K-Sedgwick/EscapeY2K/ESP GPIO Pin Details.txt

GPIO PINS THAT WORK
   CODE  |  BOARD
    0    ->   D3 -> WORKS AS INPUT
    1    ->   TX -> WORKS AS INPUT
    2    ->   D4
    3    ->   RX
    4    ->   D2 -> WORKS AS INPUT
    5    ->   D1 -> WORKS AS INPUT
    16   ->   D0
    14   ->   D5
    12   ->   D6
    13   ->   D7
    15   ->   D8
