K-Sedgwick/EscapeY2K/Control_Panel_Page/img/reset.png

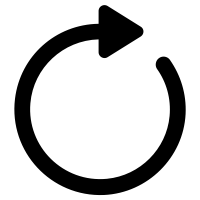
Control_Panel_Page/img/reset.png
