K-Sedgwick/EscapeY2K/Images/EscapeY2K_Wifi_Settings.png

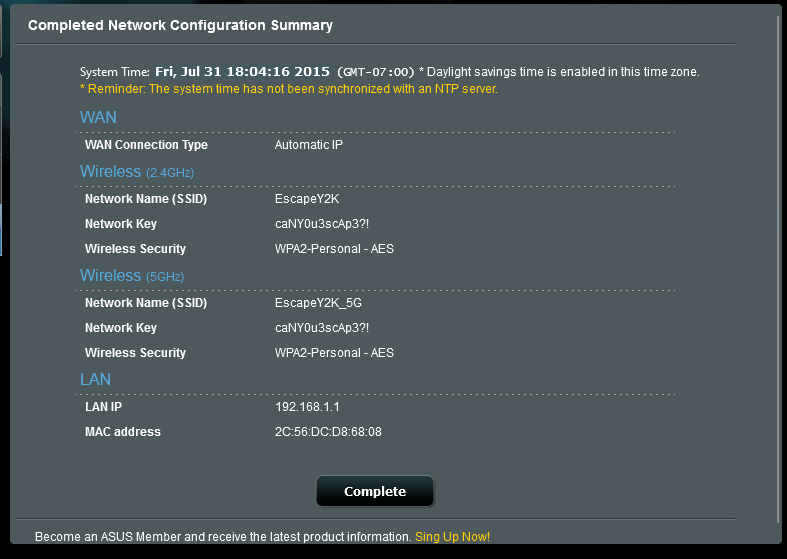
Images/EscapeY2K_Wifi_Settings.png
