K-Sedgwick/EscapeY2K/Project_Document_LaTeX/Images/ClosedLock.png

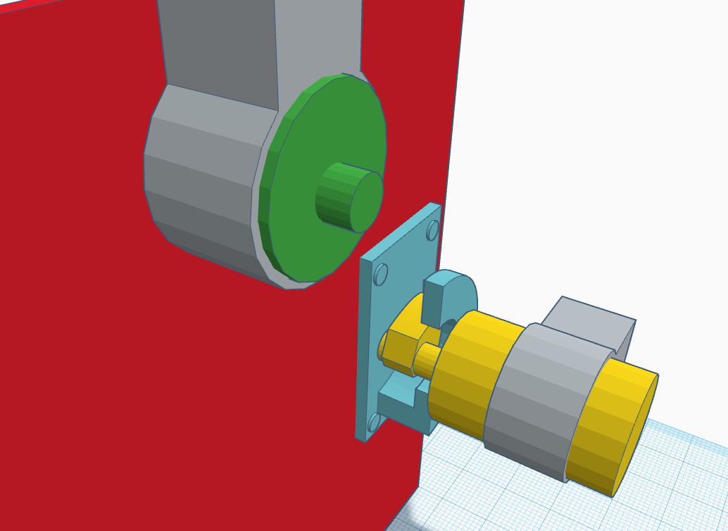
Project_Document_LaTeX/Images/ClosedLock.png
