K-Sedgwick/EscapeY2K/Project_Document_LaTeX/Images/Earfbound3DTrans.png

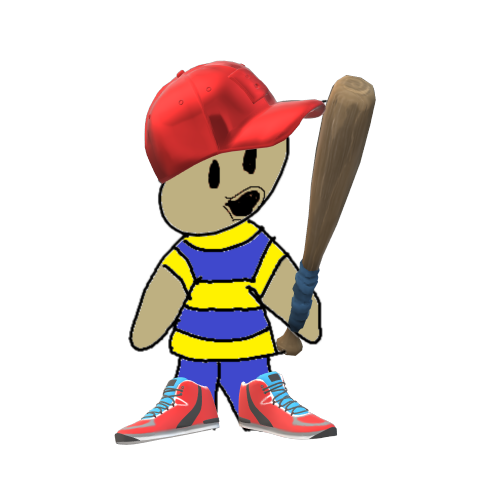
Project_Document_LaTeX/Images/Earfbound3DTrans.png
