K-Sedgwick/EscapeY2K/Project_Document_LaTeX/Images/early_autobox.jpg

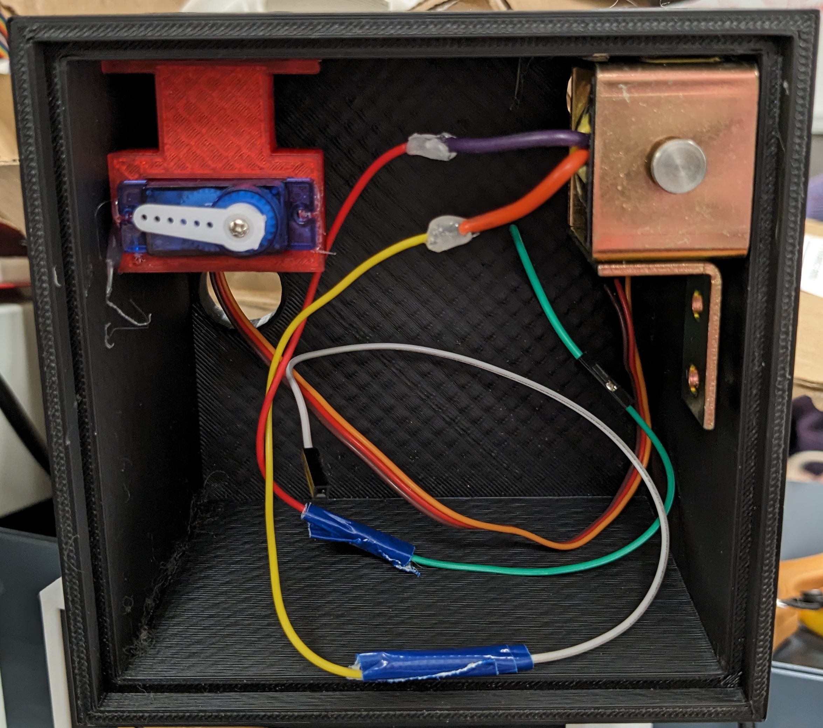
Project_Document_LaTeX/Images/early_autobox.jpg
