K-Sedgwick/EscapeY2K/Project_Document_LaTeX/Images/EscapeRoomIsoFront.jpg

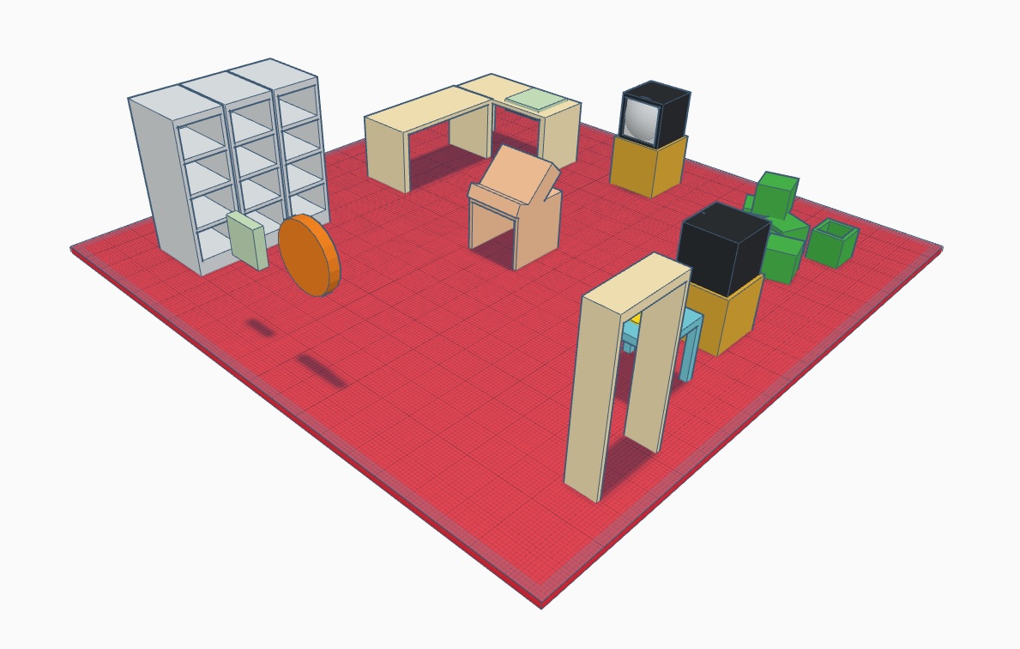
Project_Document_LaTeX/Images/EscapeRoomIsoFront.jpg
