K-Sedgwick/EscapeY2K/Project_Document_LaTeX/Images/EscapeRoomIsoRear.jpg

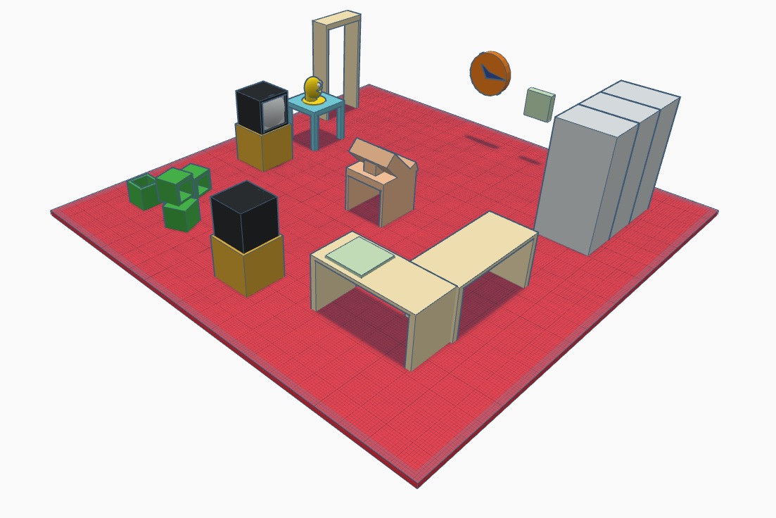
Project_Document_LaTeX/Images/EscapeRoomIsoRear.jpg
