K-Sedgwick/EscapeY2K/Project_Document_LaTeX/Images/OpenLock.png

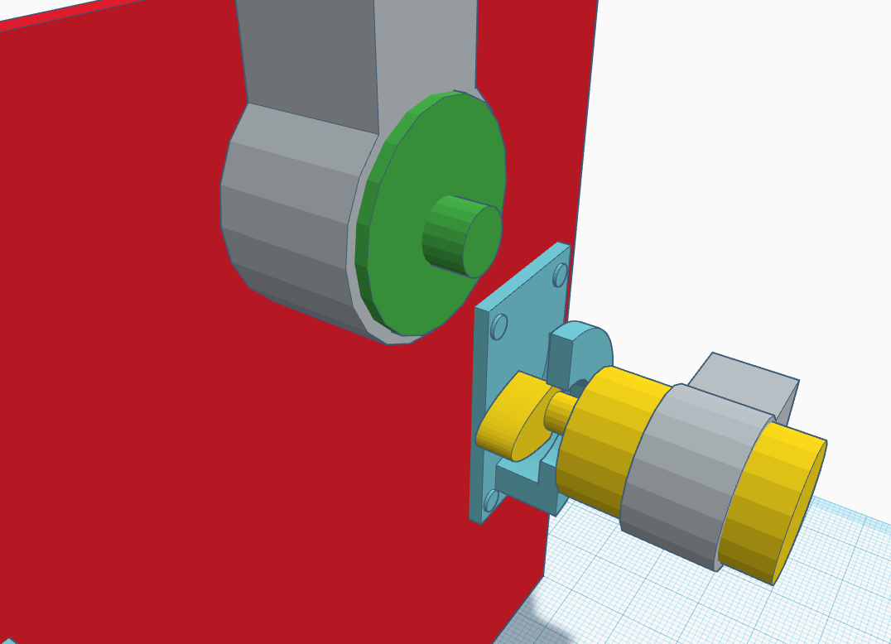
Project_Document_LaTeX/Images/OpenLock.png
