K-Sedgwick/EscapeY2K/Project_Document_LaTeX/Images/pebble charger.jpg

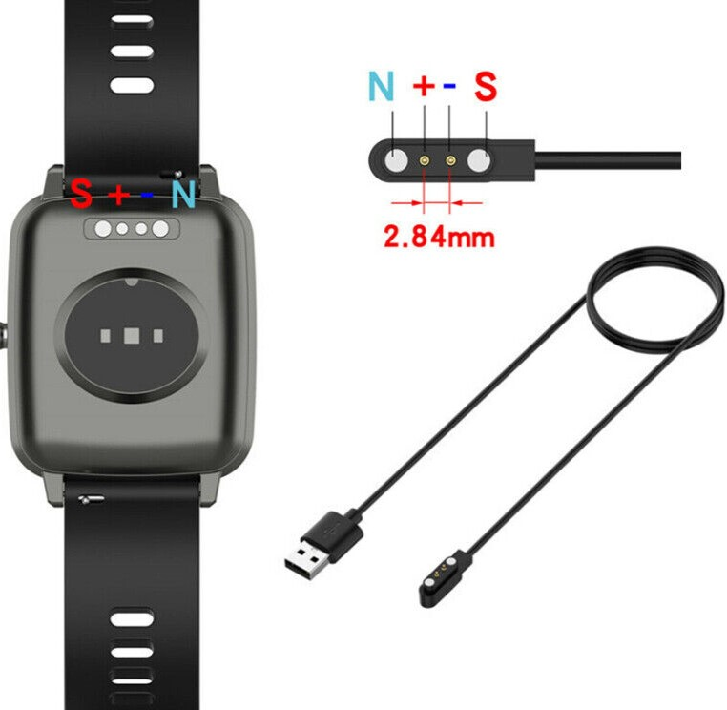
Project_Document_LaTeX/Images/pebble charger.jpg
