K-Sedgwick/EscapeY2K/Project_Document_LaTeX/Images/plugboard.jpg

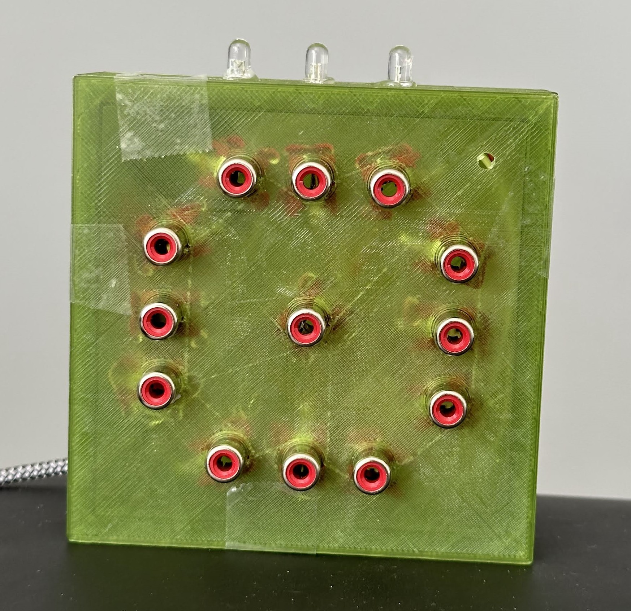
Project_Document_LaTeX/Images/plugboard.jpg
