K-Sedgwick/EscapeY2K/Project_Document_LaTeX/Images/tvcomparison.png

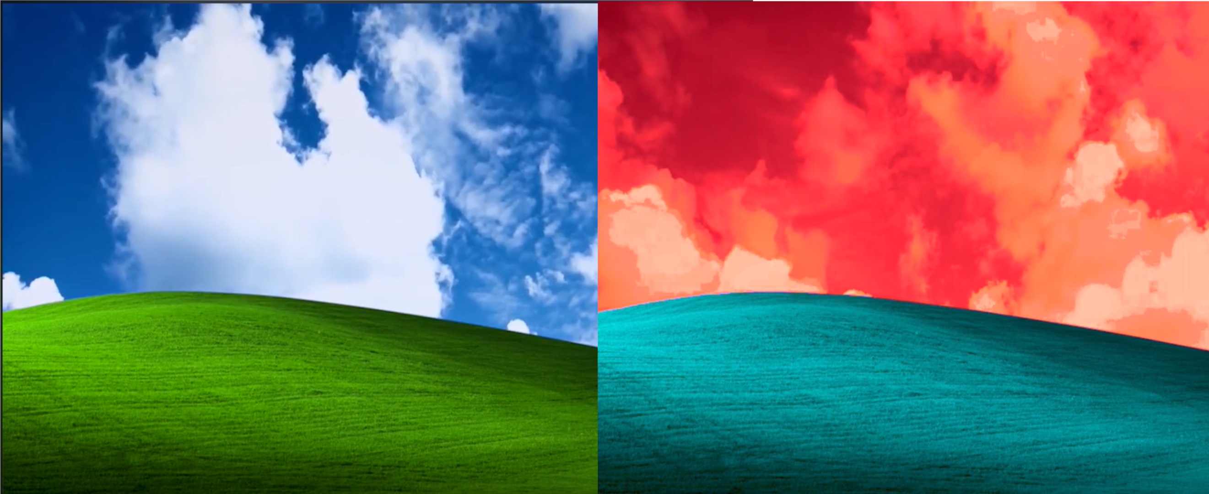
Project_Document_LaTeX/Images/tvcomparison.png
