K-Sedgwick/EscapeY2K/Project_Document_LaTeX/Images/tvsketch.png

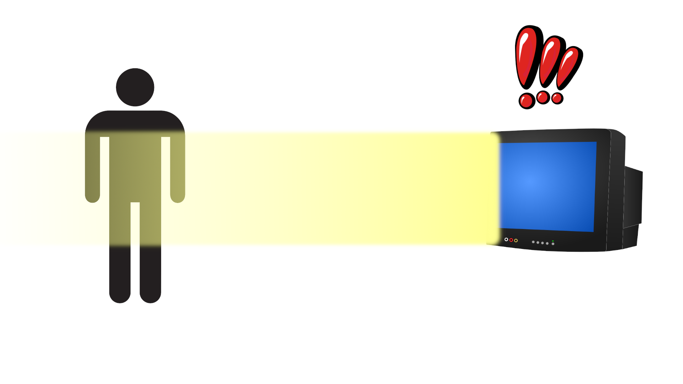
Project_Document_LaTeX/Images/tvsketch.png
