K-Sedgwick/EscapeY2K/Project_Document_LaTeX/newenergytable.png

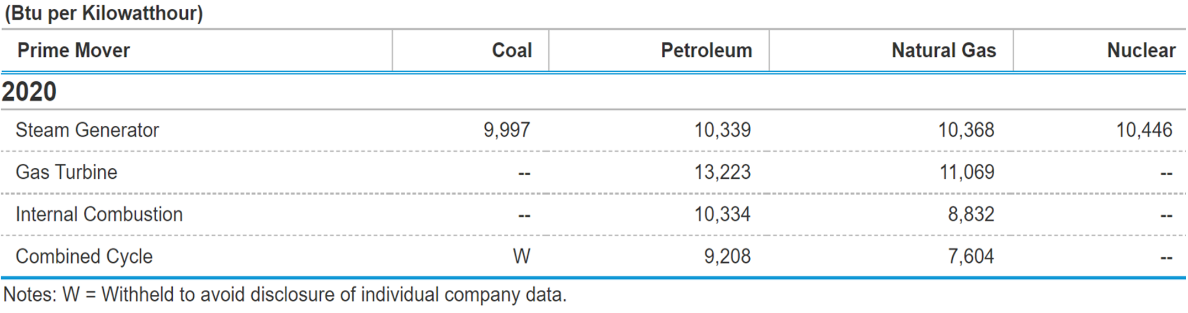
Project_Document_LaTeX/newenergytable.png
