K-Sedgwick/EscapeY2K/Website/img/celery.png

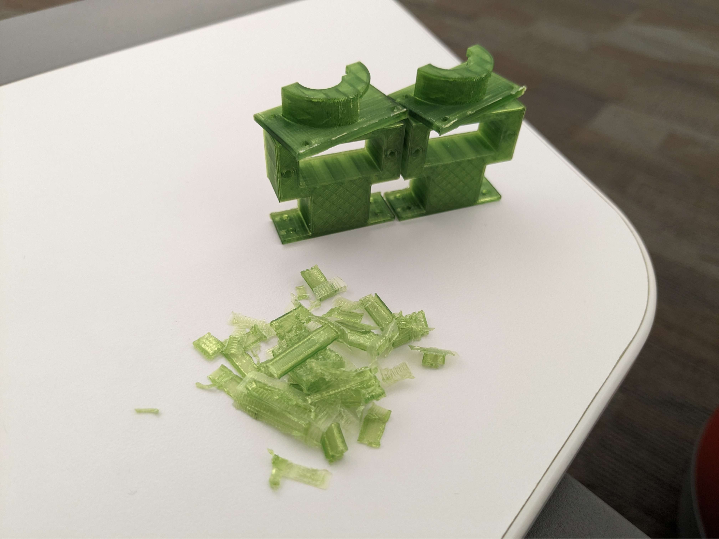
Website/img/celery.png
