K-Sedgwick/EscapeY2K/Website/img/classified-note.png

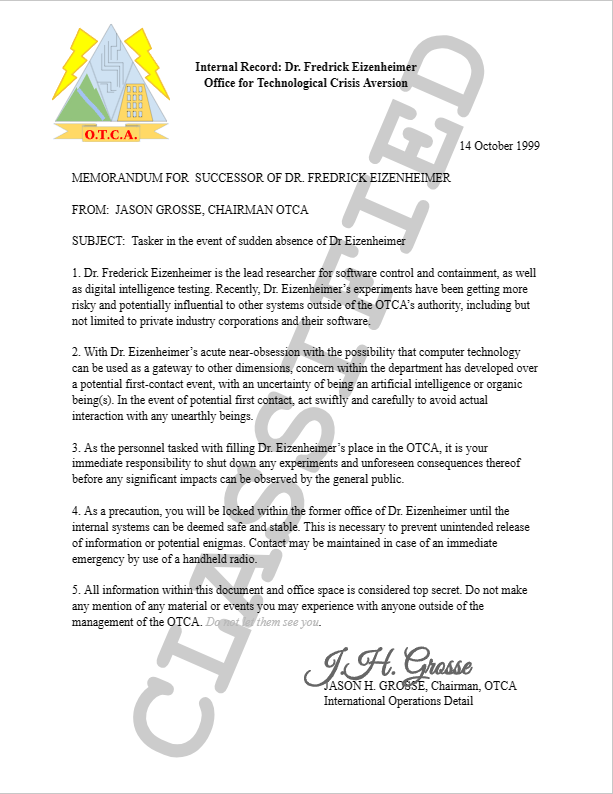
Website/img/classified-note.png
