K-Sedgwick/EscapeY2K/Website/img/clock-rotary-mount.jpg

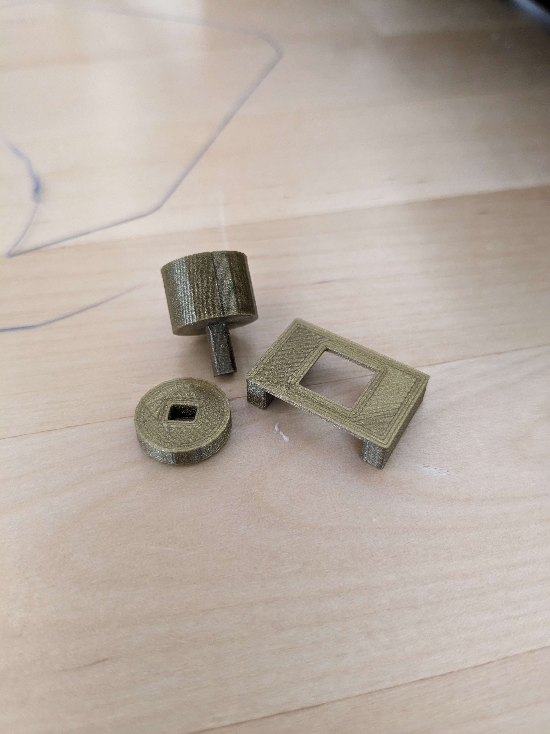
Website/img/clock-rotary-mount.jpg
