K-Sedgwick/EscapeY2K/Website/img/combos.png

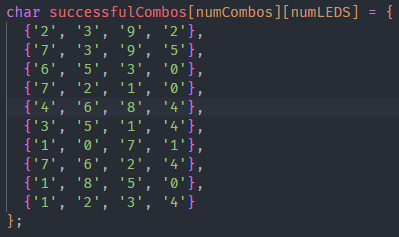
Website/img/combos.png
