K-Sedgwick/EscapeY2K/Website/img/dial-back-in-plate.png

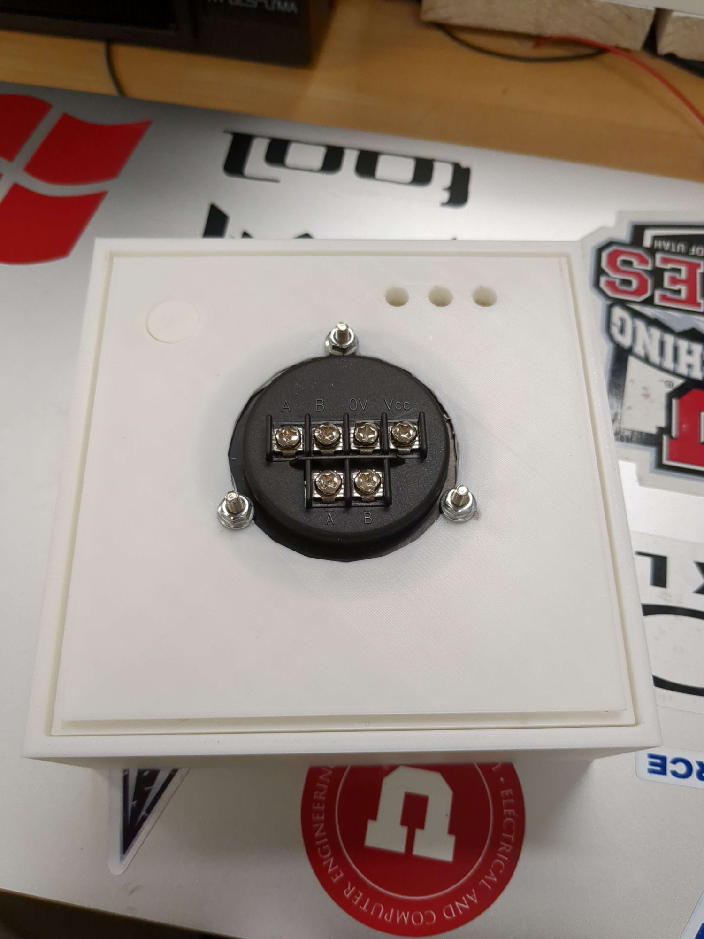
Website/img/dial-back-in-plate.png
