K-Sedgwick/EscapeY2K/Website/img/dial.png

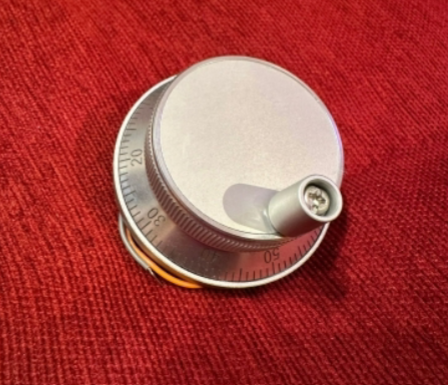
Website/img/dial.png
