K-Sedgwick/EscapeY2K/Website/img/door open.png

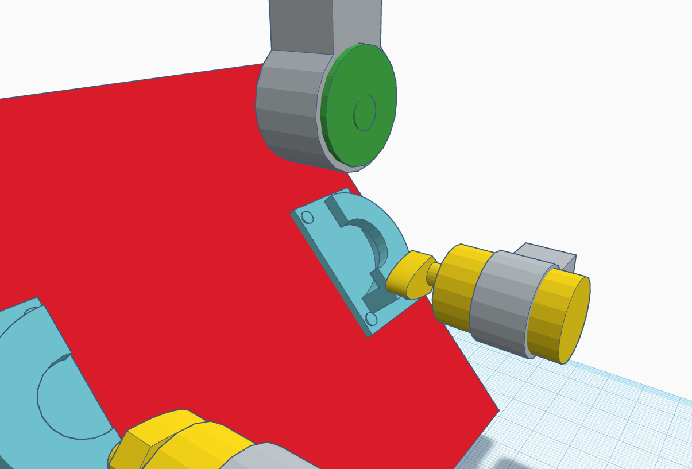
Website/img/door open.png
