K-Sedgwick/EscapeY2K/Website/img/door with locks.png

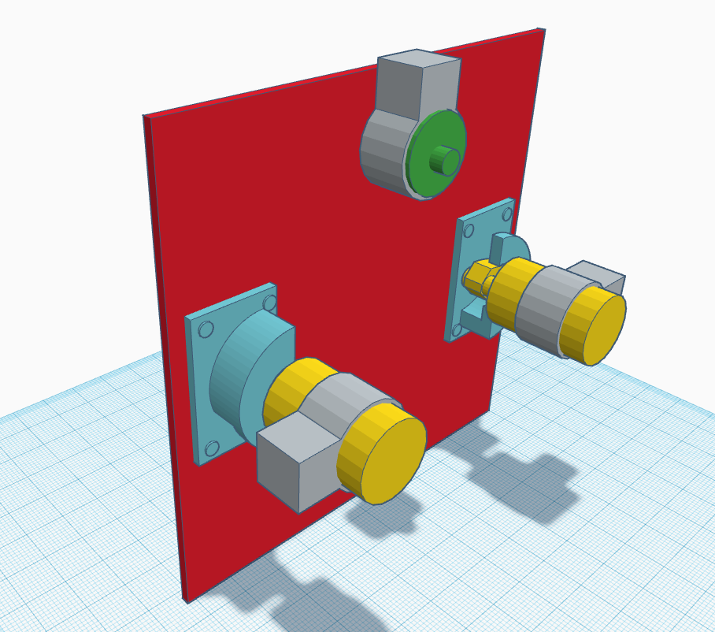
Website/img/door with locks.png
