K-Sedgwick/EscapeY2K/Website/img/Escape Room Y2K.jpg

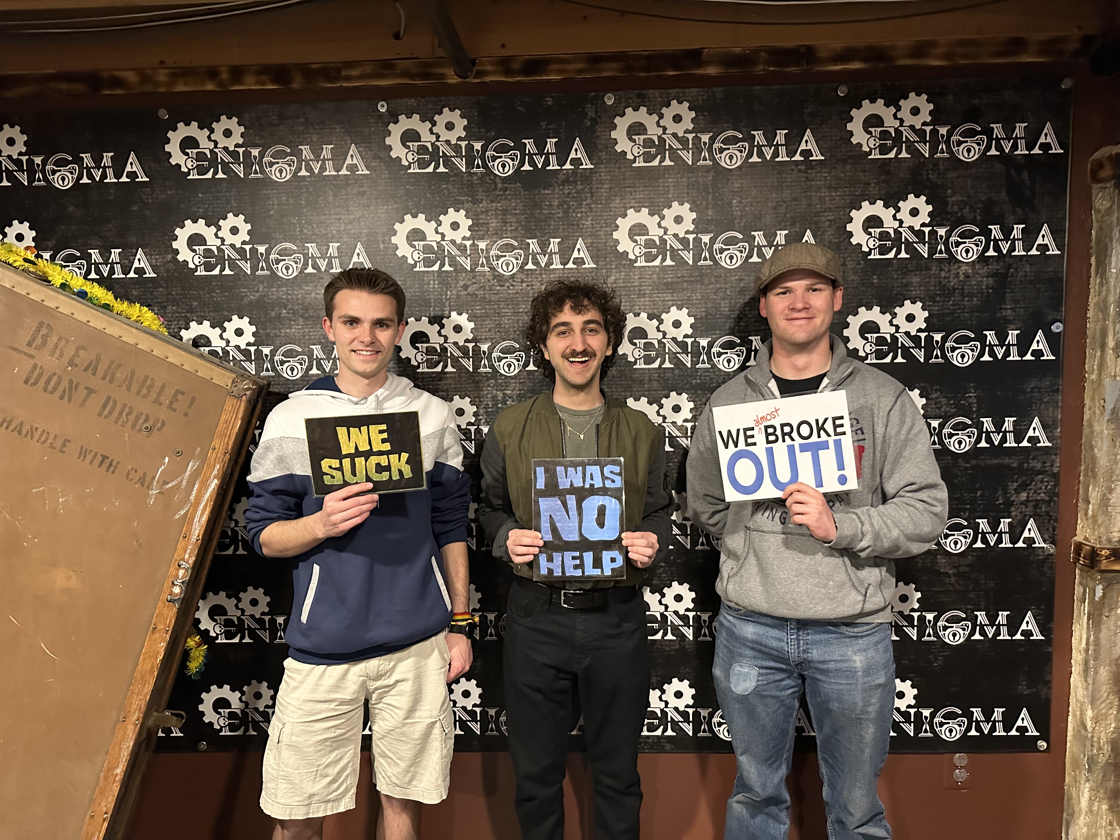
Website/img/Escape Room Y2K.jpg
