K-Sedgwick/EscapeY2K/Website/img/escape-room-2.jpg

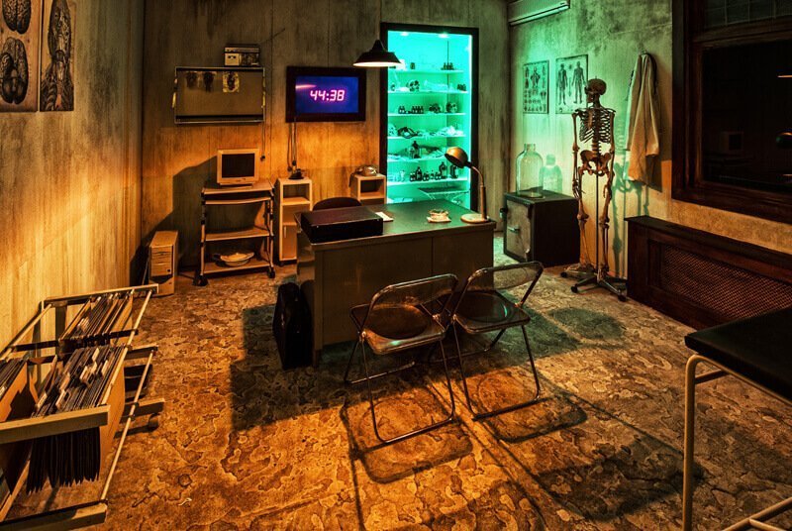
Website/img/escape-room-2.jpg
