K-Sedgwick/EscapeY2K/Website/img/final-box-pcb.png

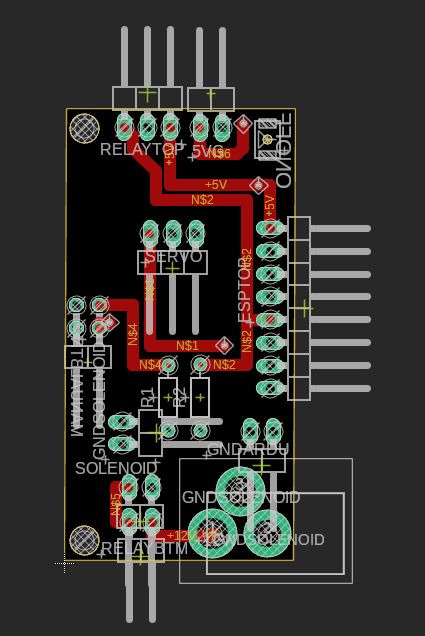
Website/img/final-box-pcb.png
