K-Sedgwick/EscapeY2K/Website/img/hiding-from-monster.jpg

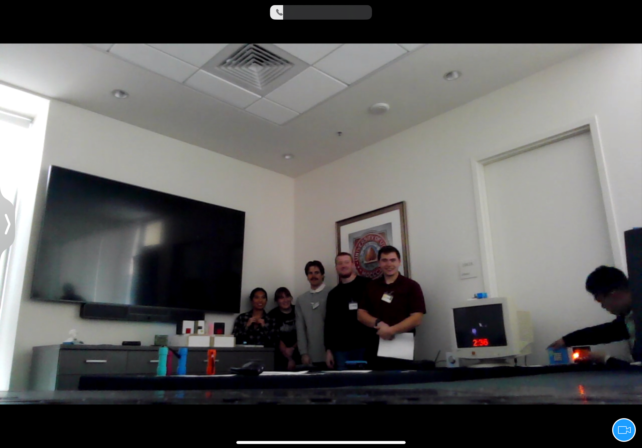
Website/img/hiding-from-monster.jpg
