K-Sedgwick/EscapeY2K/Website/img/jake-pic.JPG

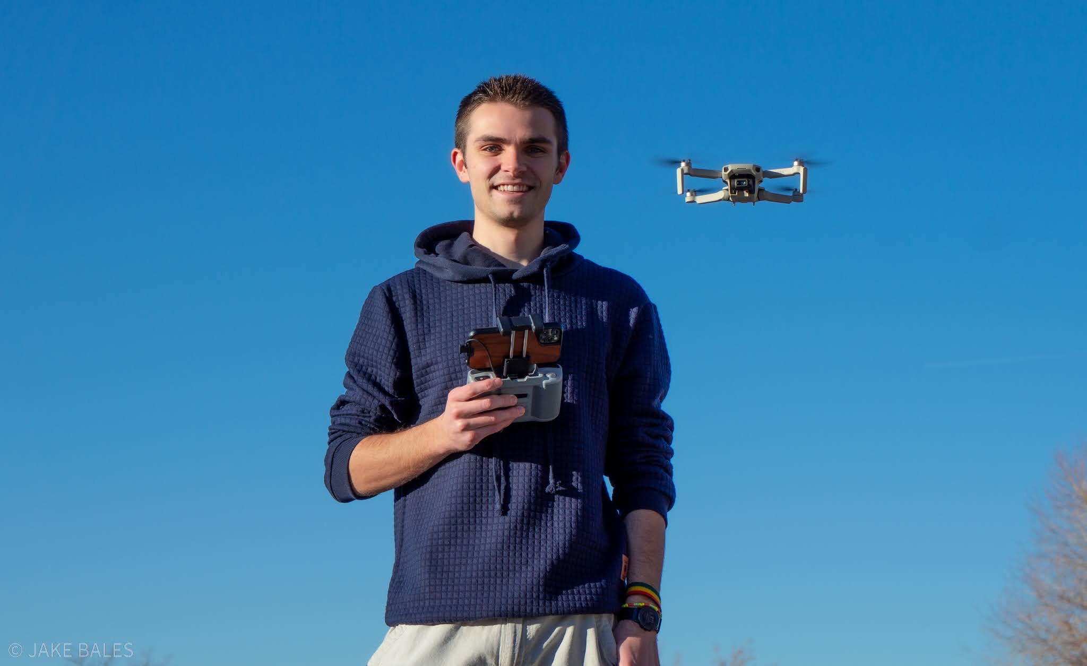
Website/img/jake-pic.JPG
