K-Sedgwick/EscapeY2K/Website/img/kyle-pic.png

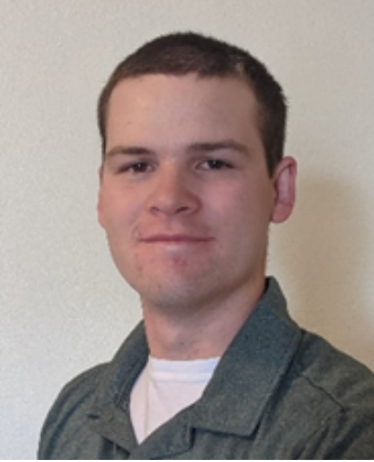
Website/img/kyle-pic.png
