K-Sedgwick/EscapeY2K/Website/img/lock mockup.png

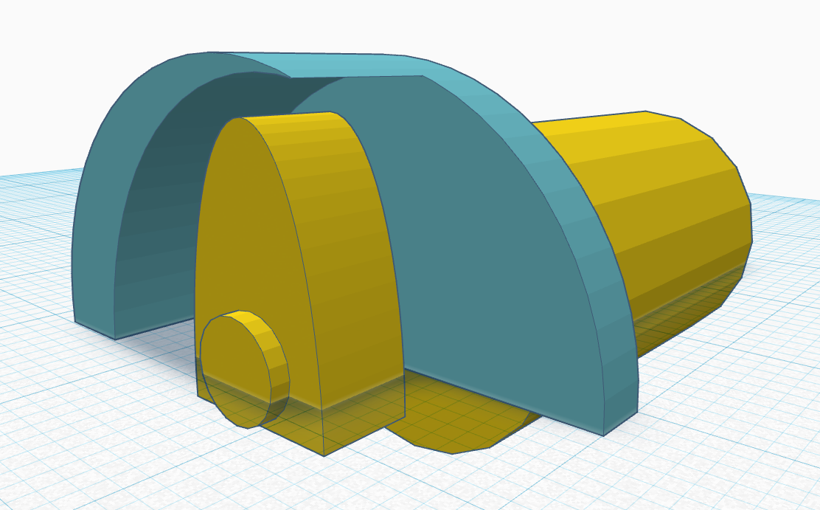
Website/img/lock mockup.png
