K-Sedgwick/EscapeY2K/Website/img/monster-motion-sensor-enclosures.png

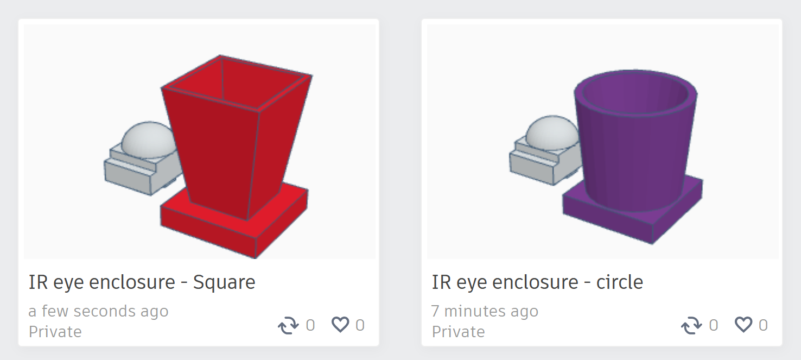
Website/img/monster-motion-sensor-enclosures.png
