K-Sedgwick/EscapeY2K/Website/img/nami-exploded.png

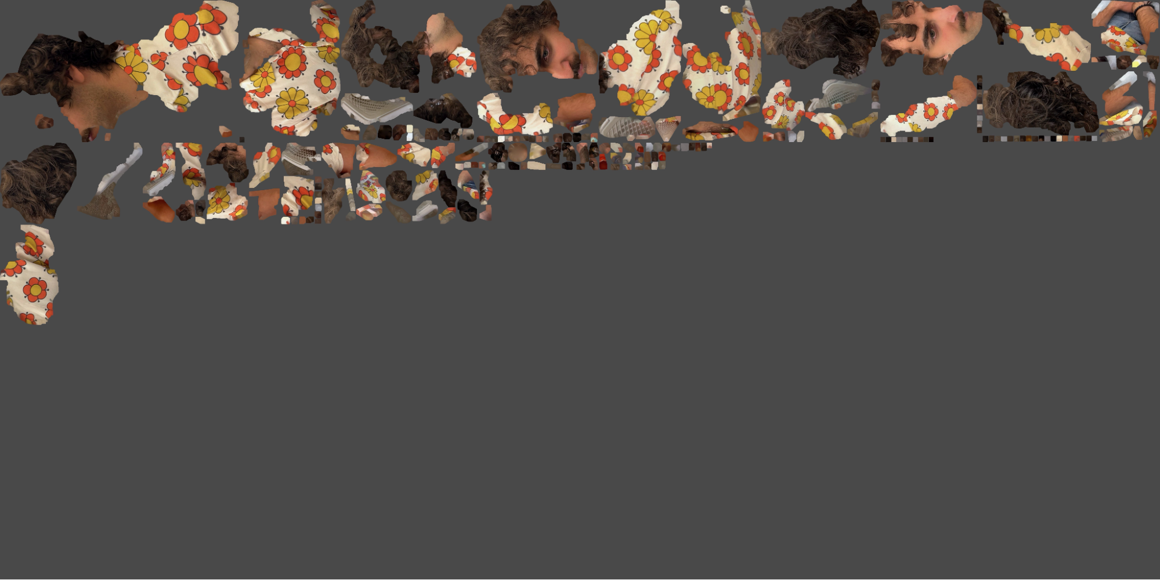
Website/img/nami-exploded.png
