K-Sedgwick/EscapeY2K/Website/img/nami-lol.png

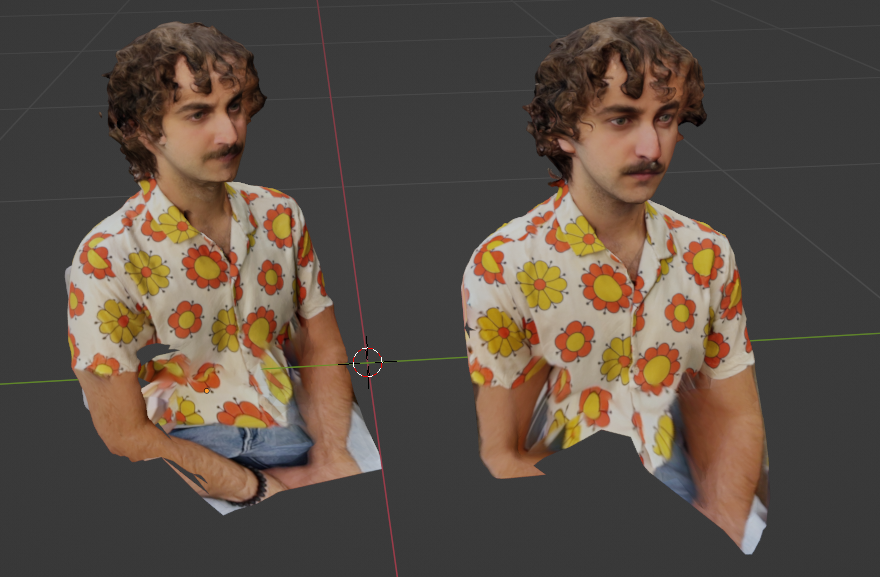
Website/img/nami-lol.png
