K-Sedgwick/EscapeY2K/Website/img/nami-pic.jpg

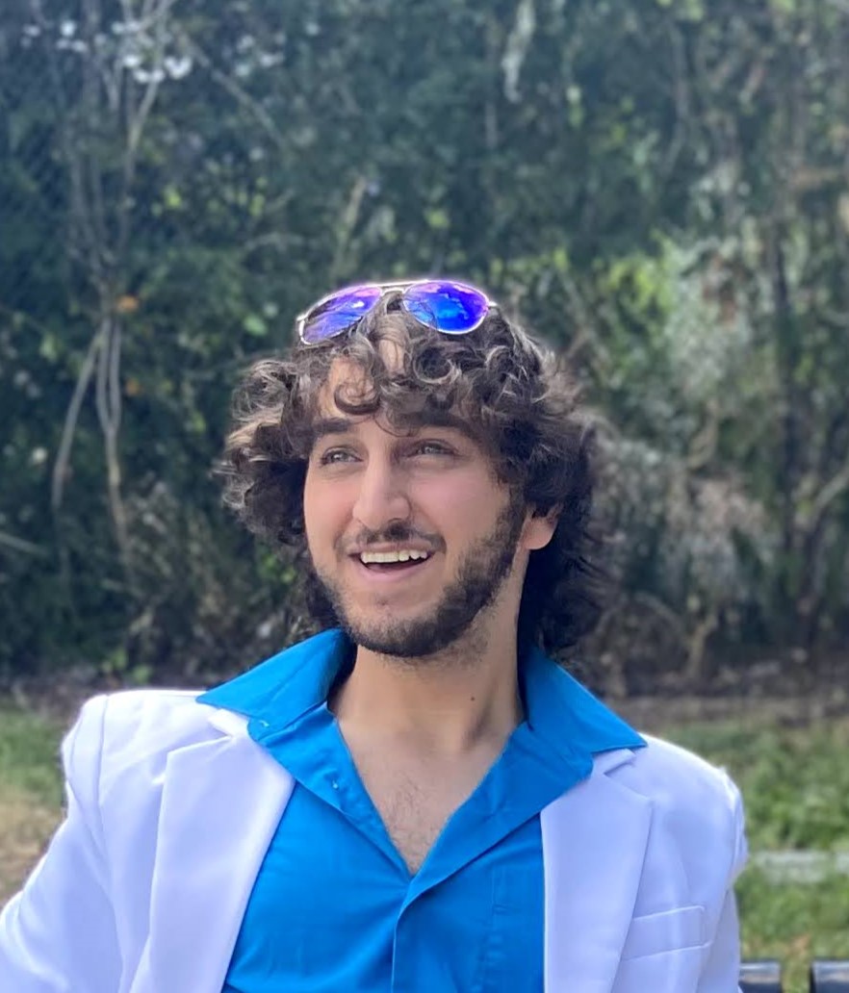
Website/img/nami-pic.jpg
