K-Sedgwick/EscapeY2K/Website/img/nami-vrrrrr.png

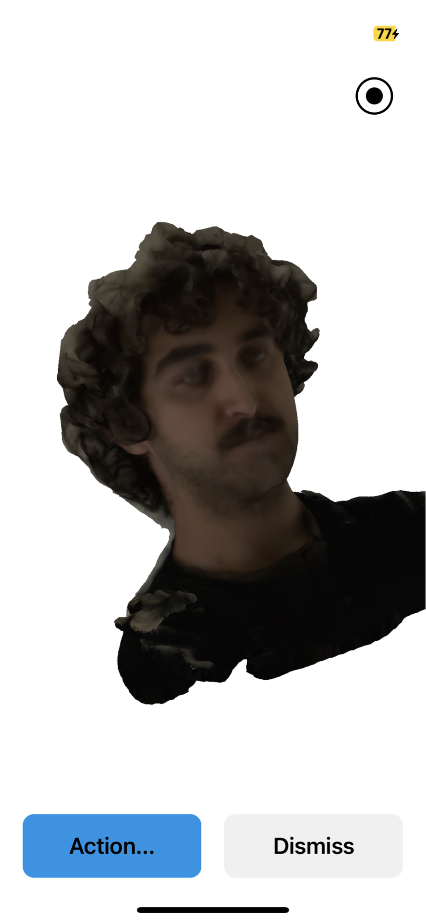
Website/img/nami-vrrrrr.png
