K-Sedgwick/EscapeY2K/Website/img/plugboard-puzzle-working.jpg

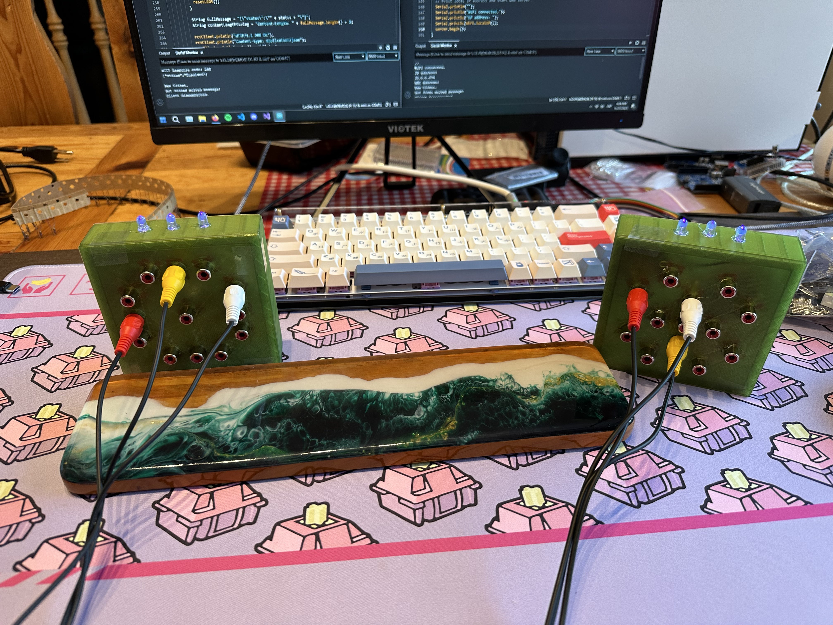
Website/img/plugboard-puzzle-working.jpg
