K-Sedgwick/EscapeY2K/Website/img/POSTER.png

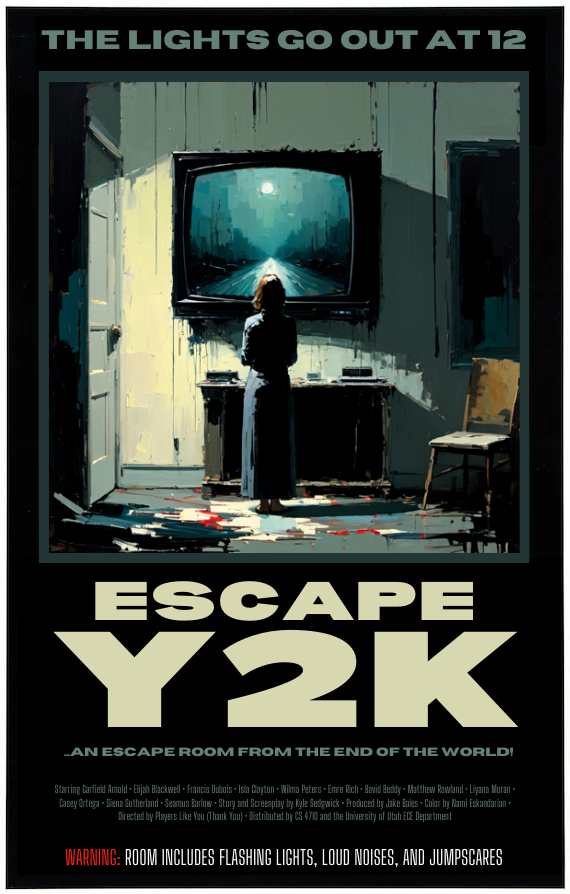
Website/img/POSTER.png
