K-Sedgwick/EscapeY2K/Website/img/room.webp

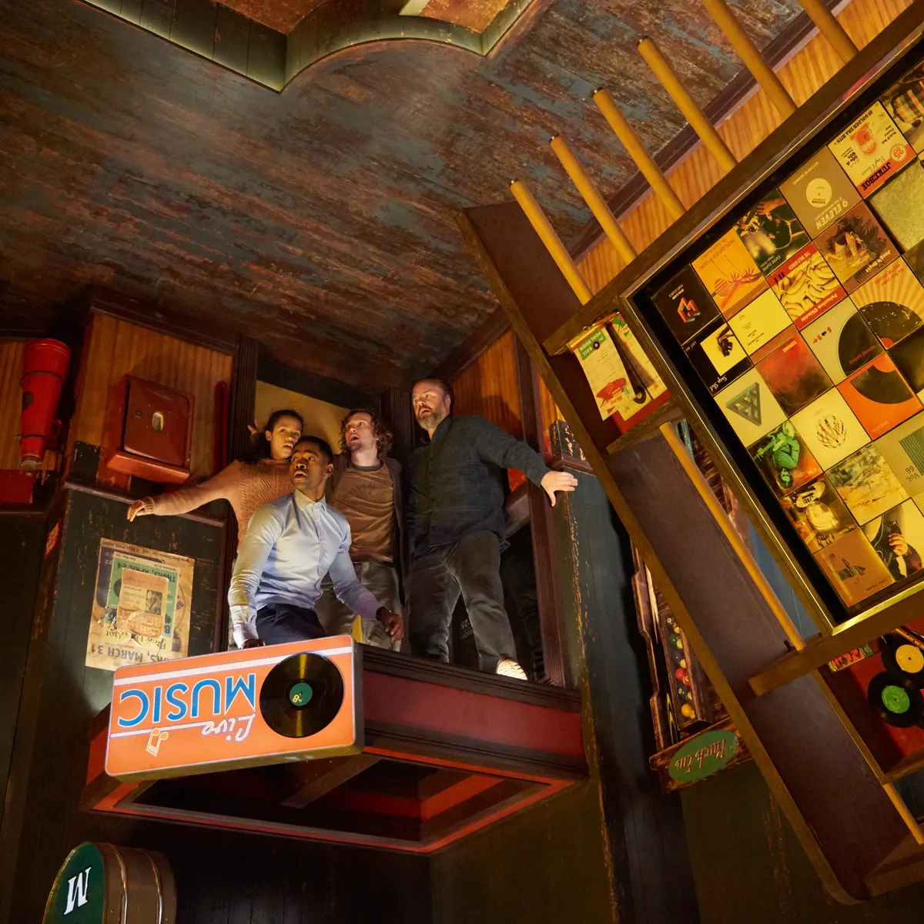
Website/img/room.webp
