K-Sedgwick/EscapeY2K/Website/img/roomLayout.png

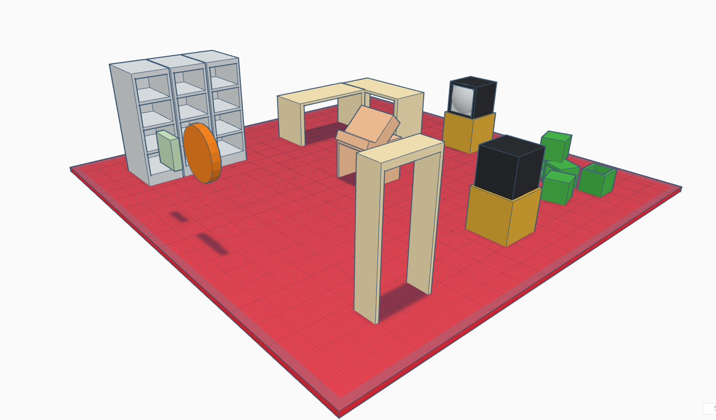
Website/img/roomLayout.png
