K-Sedgwick/EscapeY2K/Website/img/safety-third.jpg

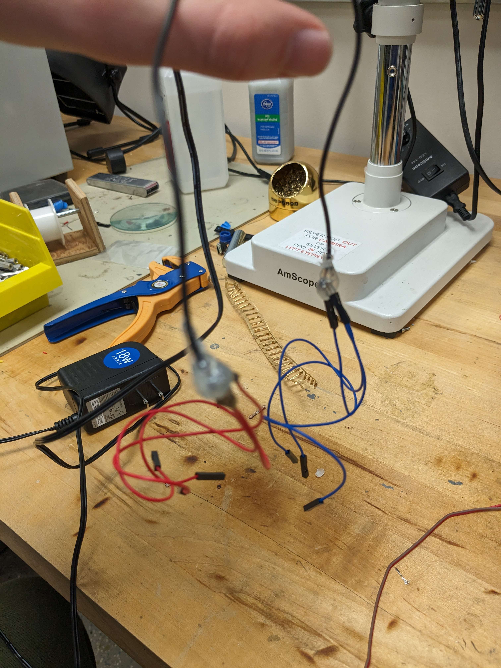
Website/img/safety-third.jpg
