K-Sedgwick/EscapeY2K/Website/img/scientist-kyle-and-jake.jpg

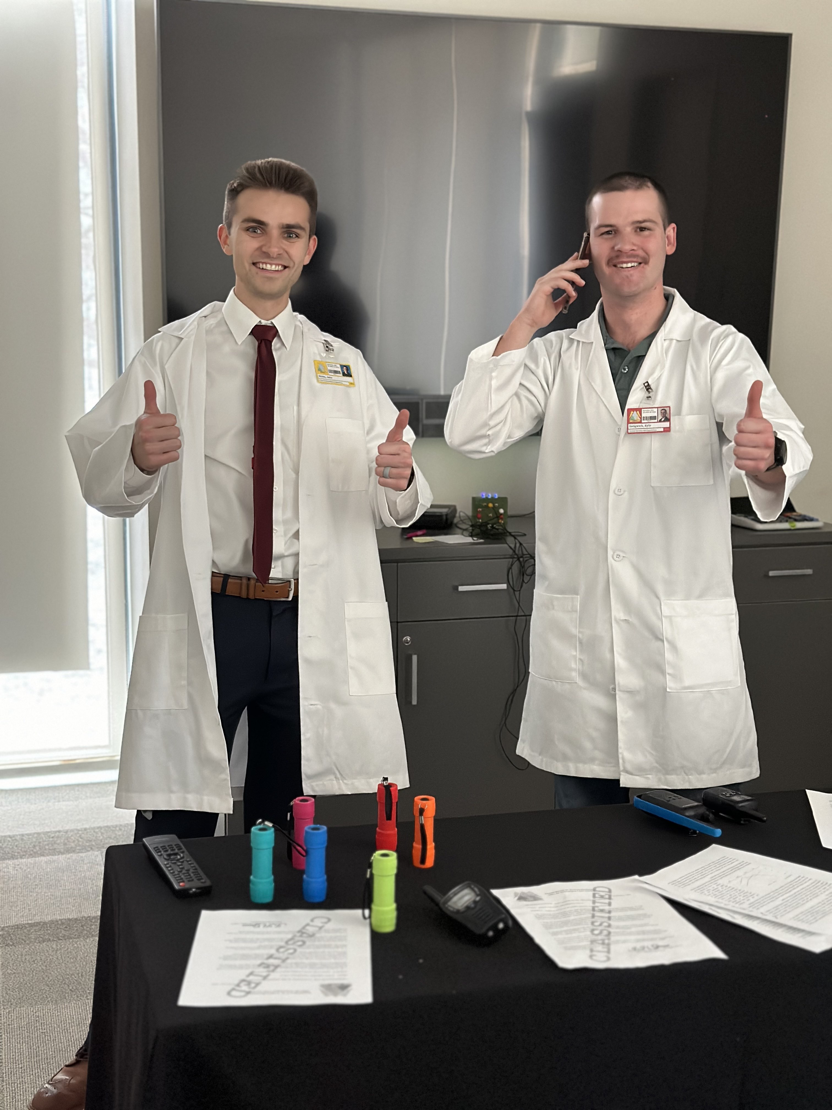
Website/img/scientist-kyle-and-jake.jpg
