K-Sedgwick/EscapeY2K/Website/img/second-crt.jpg

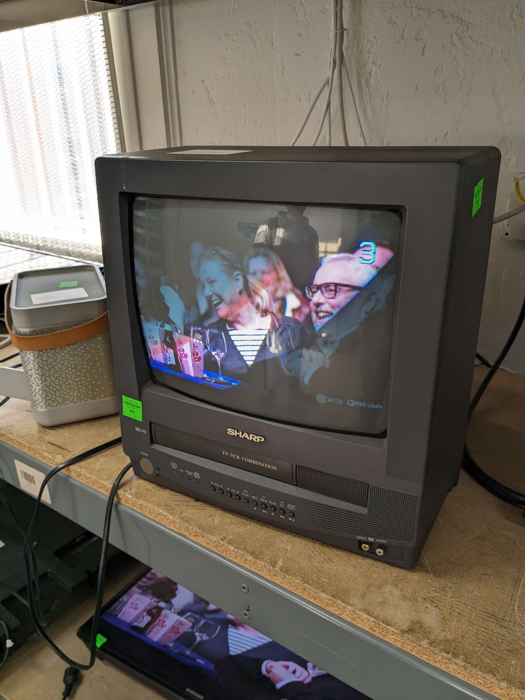
Website/img/second-crt.jpg
