K-Sedgwick/EscapeY2K/Website/img/servo-in-mount.png

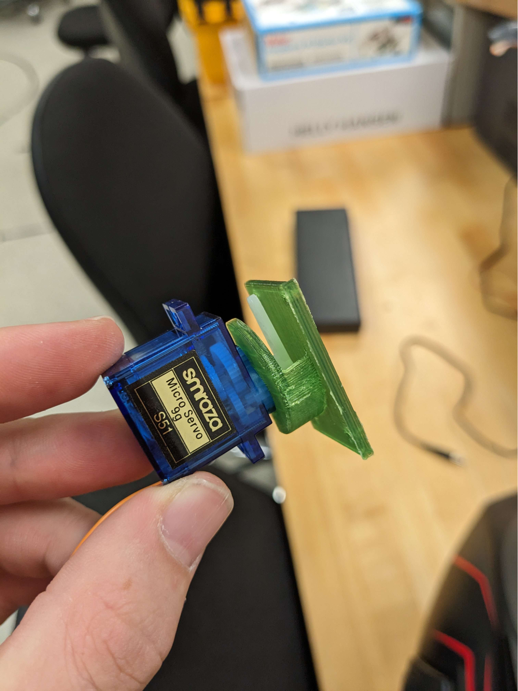
Website/img/servo-in-mount.png
