K-Sedgwick/EscapeY2K/Control_Panel_Page/testingESP.html

Reset Room

Status Refresh in {{timeUntilStatusRefresh}}

## Puzzles and Other

### TV's

Activate Monster Deactivate Monster Seek Normal

### Puzzles

#### Dial Puzzle:

Enable Disable Mark as Solved

#### Potentiometers:

Enable Disable Mark as Solved

#### 5-Digit Number Combo:

Enable Disable Mark as Solved

Reset

### Clock Stuff

Refresh

#### Rotary Count: {{status.rotaryCounter}}

#### Clock Status: {{status.clockmode}}

Pause Clock Tick Normally Reverse Fast Forward

### Puzzles that have been solved

##### {{capitalizeFirstLetter(name)}}

### Phone Base

Play Pause Vol Min Vol Max

### Tape Player

Play Pause Vol Min Vol Max

## Lockboxes

### Box {{index+1}}

Activate Box

##### Are you sure you want to reset the room?

×

Close RESET
