K-Sedgwick/EscapeY2K/(commit log)

2023-03-24 Added brief list for required materials
2023-04-15 User button activates "time reverse mode"
    [main.c]
2023-04-18 One button works, other button interrupt bad
2023-04-18 Backwards button works - Forward button is buggy
    [main.c]
2023-04-18 Program uses timers for ticks
2023-04-18 Buttons work!
2023-04-20 Nami wrote some PWM code, added in separate file
2023-05-04 Added story and current progress.
2023-05-04 Added more info on materials section
2023-05-04 Timer section
2023-05-04 Added pressure sensitive chair idea!
2023-09-05 Code for stepper motor
2023-09-13 Fixed receiver not understanding command
    [ESP_Webserver_SEND_AND_RECEIVE.ino]
2023-09-25 Motion detection with PIR sensors
    https://learn.adafruit.com/pir-passive-infrared-proximity-motion-sensor/using-a-pir-w-arduino
2023-09-26 Clock reset mechanism works!
    [Clock_Reset_with_Stepper.ino, LatchControl.ino]
2023-09-28 ClockFinal works on ESP. Needs slot intrptrs
2023-10-26 Prototype for the AudioControl ESP module
2023-10-26 HOLY COW WIRELESS TAPE PLAYER WORKS
2023-10-26 Change which pins are used for UART & add play btn
2023-10-26 Dial works with LEDS! :D
2023-10-30 First implementation of tv code
    Uses sample videos instead of ones used for the game.
    Has functionality for playing whichever video is desired along with selecting the position. Media player is set on repeat.
2023-11-04 Added prototype code for analog & number puzzles
2023-11-08 Added Rotary encoder code to ClockFinal
2023-11-09 Fix wifi ssid and password
    [ping.ino]
2023-11-14 added ESP output pin to analog dial puzzle
2023-11-20 Changed clock logic with rotary encoder. Untested.
2023-11-21 Added second interruptor to the clock
2023-11-29 Added marquee timer
2023-11-30 the common gnd works woo
2023-12-01 Server parses puzzle solved and informs box TBD
    [DialPuzzle.ino]
2023-12-05 Make bug handle motion sensor logic as well
    [motion.ino]
2023-12-05 Change timer
2023-12-06 Added pin 13 active low pinout
2023-12-06 finalized enable and reset on uno control puzzles
    [AnalogPuzzle.ino, NumCodePuzzle.ino]
2023-12-06 typo fix in esp code
    [AudioControl_ESP.ino]
2023-12-07 Add logic to box control to turn on LED when open
2023-12-14 Remove a couple sections and add Jakes puzzle sections
2023-12-15 Conclusion also removed my section on props and hints
2023-12-15 Added BoM
