K-Sedgwick/EscapeY2K/(notices)

Notices in the files:
Project_Document_LaTeX/STM_Code/main.c:
Copyright (c) 2023 STMicroelectronics.
All rights reserved.
This software is licensed under terms that can be found in the LICENSE file
